satyam22463/Koch-Loop-Fractal-Antenna-for-S-Band-Applications/IMG_20260421_141103857.jpg

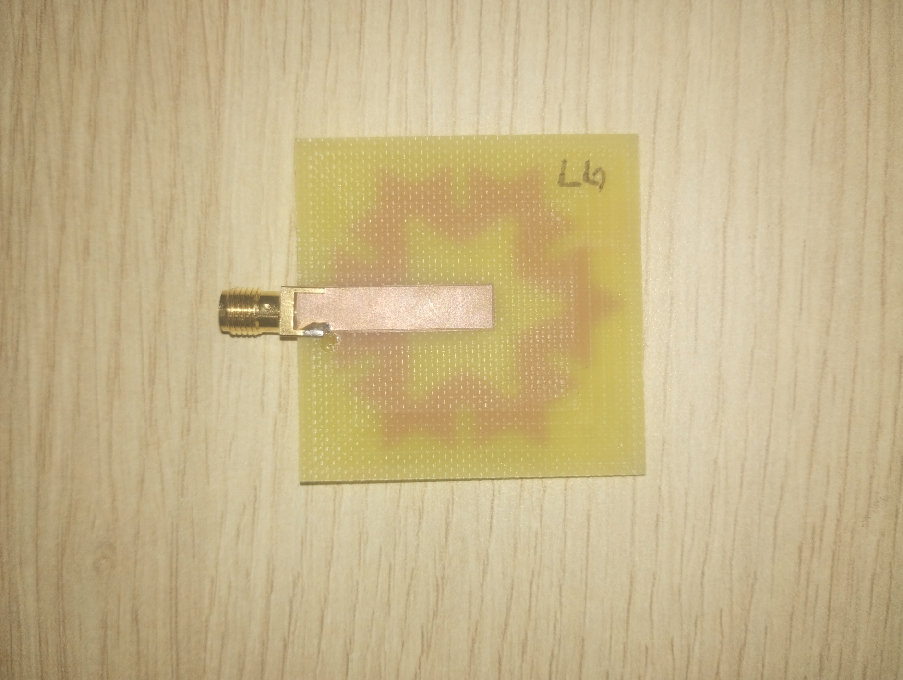
IMG_20260421_141103857.jpg
